Dong-quan/AutoCAD_Mechanical_Design/(list of files, cad)

Other CAD files:
12-D6.dwg
