Dong-quan/AutoCAD_Mechanical_Design/12-D6-A0H-BVL.pdf

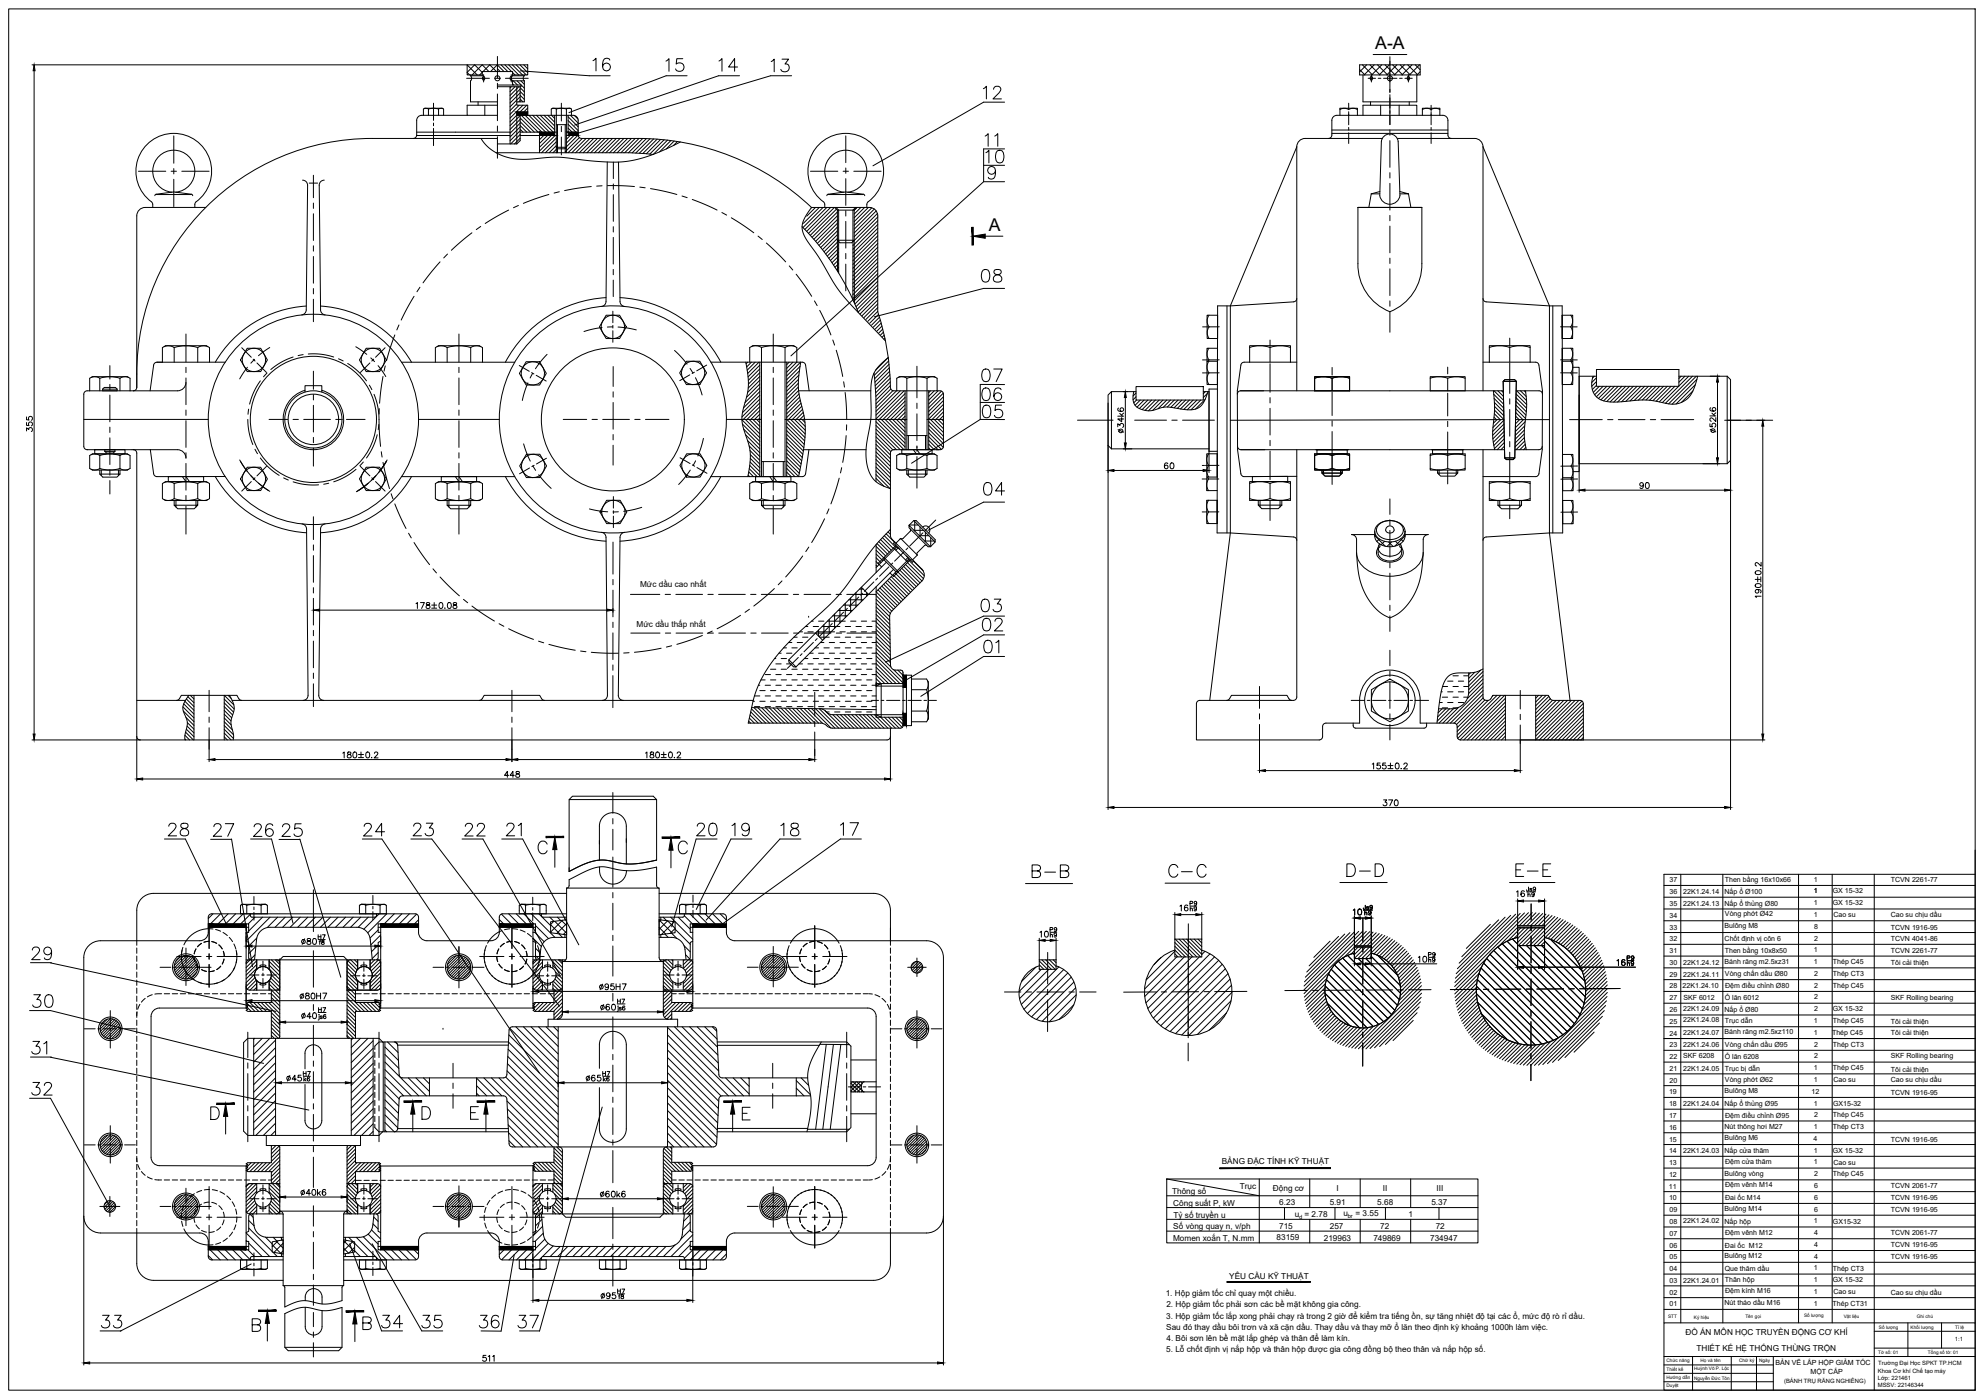
[picture p4: page 1]
Mức dầu cao nhất Mức dầu thấp nhất; Nút tháo dầu M16 Đệm kính M16 Thân hộp; Cao su Thép CT3 4 Đệm vênh M14; 6664 Đệm điều chỉnh Ø95 Bánh răng m2.5xz110 Trục dẫn Nắp ổ Ø80 Ổ lăn 6012 Đệm điều chỉnh Ø80 Vòng chắn dầu Ø80 Bánh răng m2.5xz31; Thép C45 1; Thép C45 222; Thép C45 2; Thép CT3 1; Thép C45 Then bằng 10x8x50 Vòng phớt Ø42 Nắp ổ thủng Ø80 Nắp ổ Ø100 Then bằng 16x10x66; Cao su 1; GX 15-32 GX 15-32 SKF 6012 Chức năng Thiết kế Hướng dẫn Duyệt; Họ và tên Huỳnh Võ P. Lộc Nguyễn Đức Tôn; Chữ ký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
