Dong-quan/AutoCAD_Mechanical_Design/12-D6-A3H-BANHRANG1.pdf

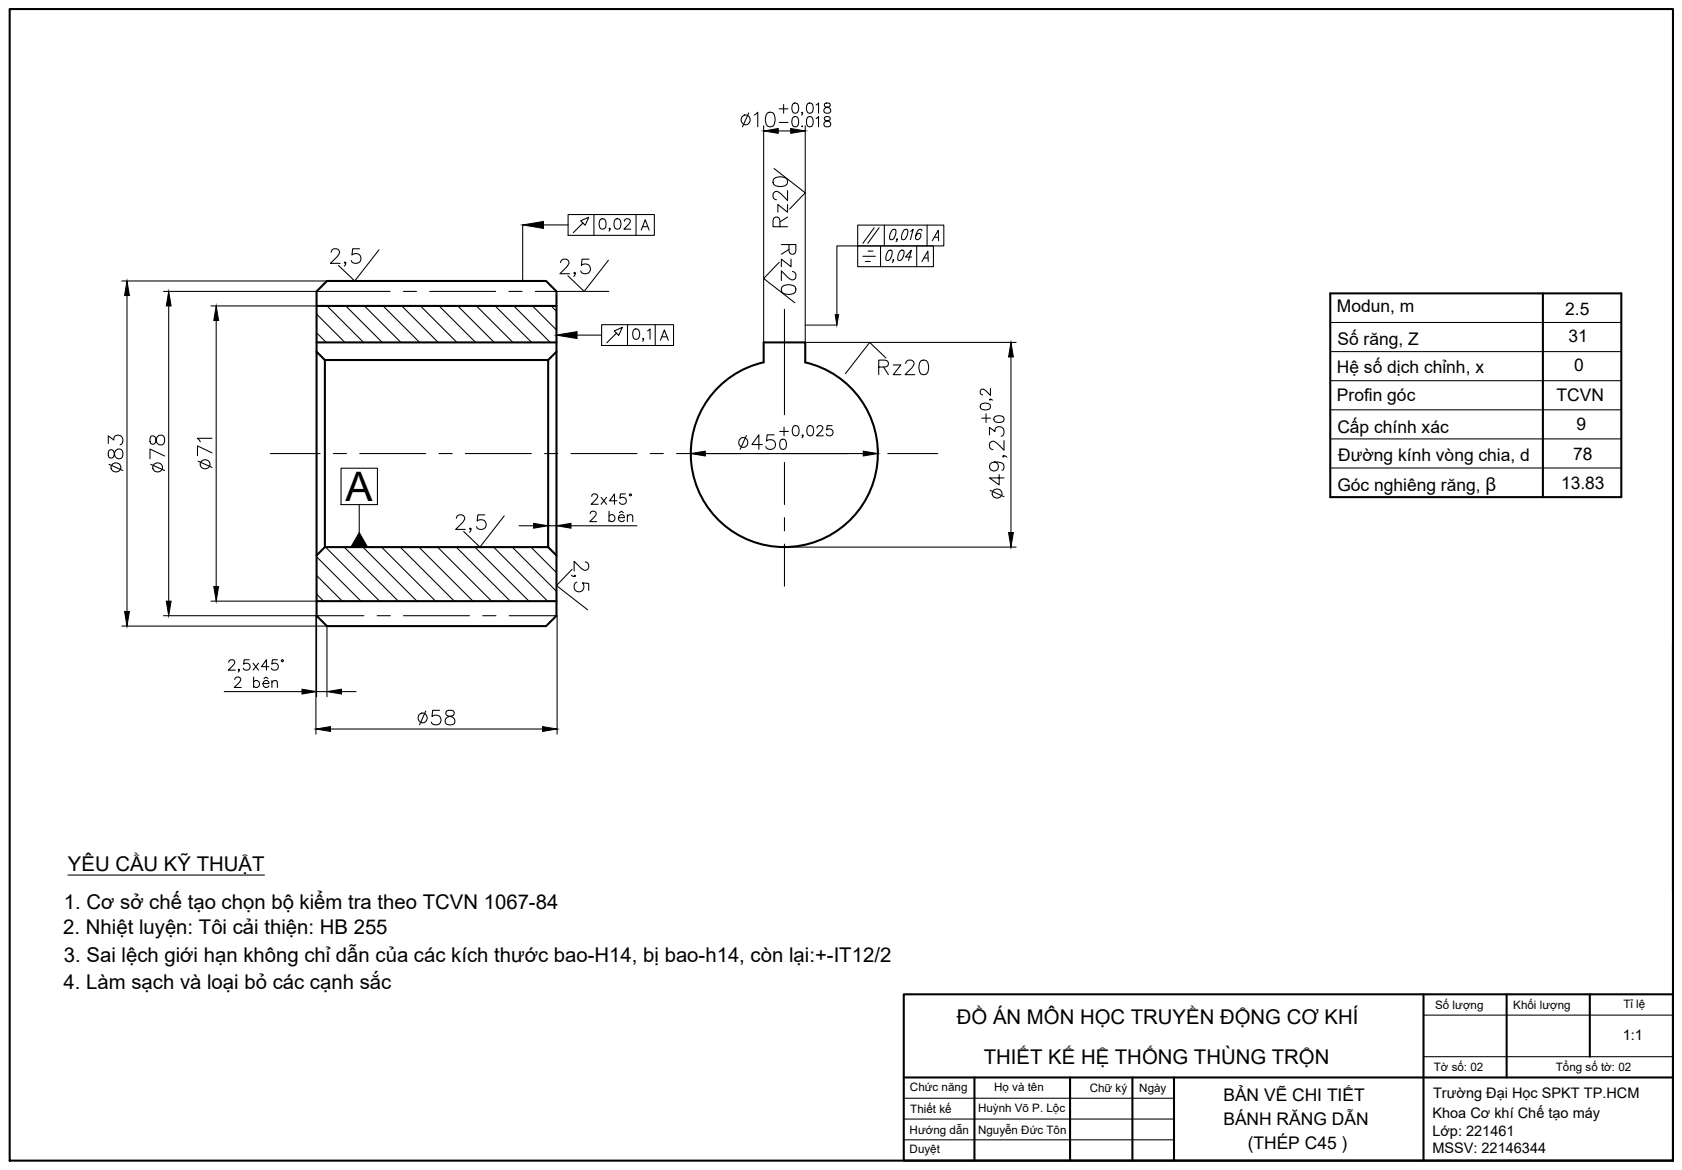
[picture p5: page 1]

Modun, m | 2.5
Số răng, Z | 31
Hệ số dịch chỉnh, x | 0

Profin góc | TCVN
Cấp chính xác | 9
Đường kính vòng chia, d | 78

Góc nghiêng răng, β

YÊU CẦU KỸ THUẬT

1. Cơ sở chế tạo chọn bộ kiểm tra theo TCVN 1067-84
2. Nhiệt luyện: Tôi cải thiện: HB 255
3. Sai lệch giới hạn không chỉ dẫn của các kích thước bao-H14, bị bao-h14, còn lại:+-IT12/2
4. Làm sạch và loại bỏ các cạnh sắc

ĐỒ ÁN MÔN HỌC TRUYỀN ĐỘNG CƠ KHÍ THIẾT KẾ HỆ THỐNG THÙNG TRỘN | Số lượng | Khối lượng | Tỉ lệ

Tờ số: 02 | Tổng số tờ: 02

Chức năng | Họ và tên | Chữ ký | Ngày | BẢN VẼ CHI TIẾT BÁNH RĂNG DẪN (THÉP C45 ) | Trường Đại Học SPKT TP.HCM Khoa Cơ khí Chế tạo máy Lớp: 221461 MSSV: 22146344
Thiết kế | Huỳnh Võ P. Lộc
Hướng dẫn | Nguyễn Đức Tôn
Duyệt
