Dong-quan/AutoCAD_Mechanical_Design/12-D6-A3H-TRUC1.pdf

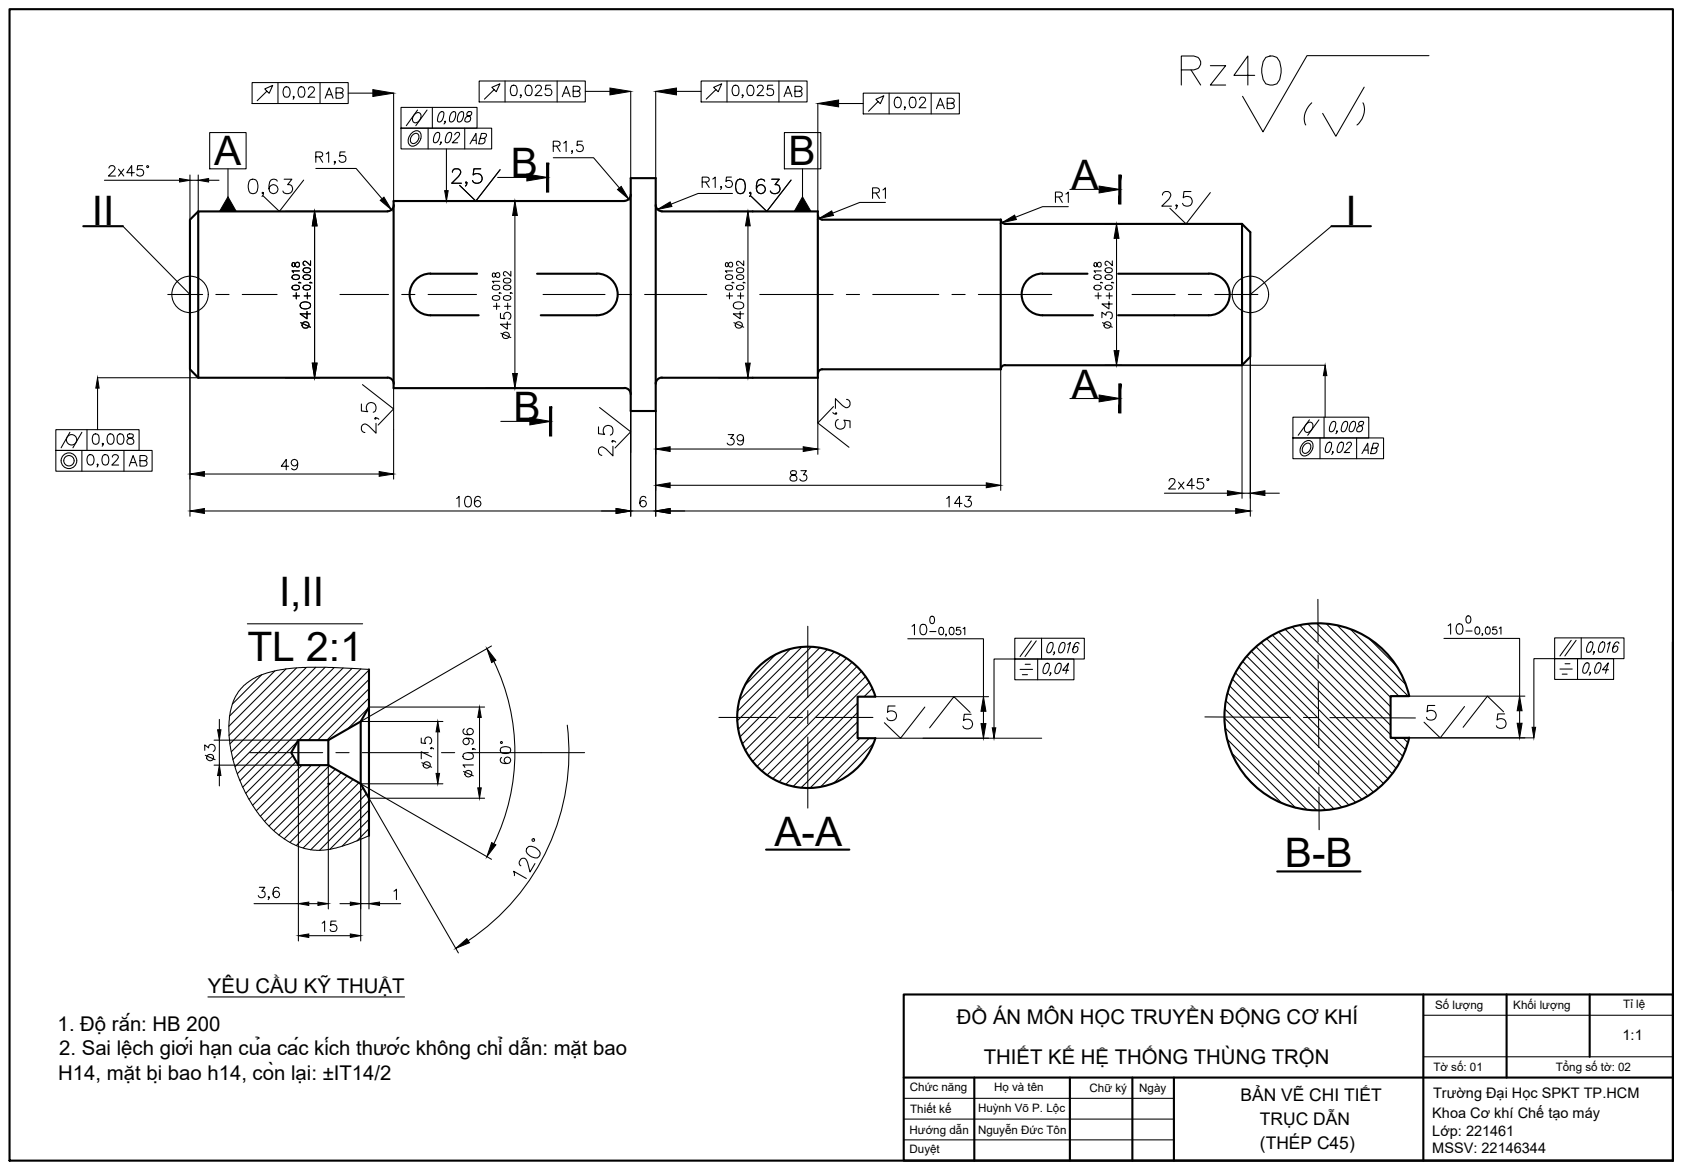
[picture p6: page 1]

YÊU CẦU KỸ THUẬT

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

2. Sai lệch giới hạn của các kích thước không chỉ dẫn: mặt bao
H14, mặt bị bao h14, còn lại: ±IT14/2

Tờ số: 01 | Tổng số tờ: 02

Chức năng | Họ và tên | Chữ ký | Ngày | BẢN VẼ CHI TIẾT TRỤC DẪN (THÉP C45) | Trường Đại Học SPKT TP.HCM Khoa Cơ khí Chế tạo máy Lớp: 221461 MSSV: 22146344
Thiết kế | Huỳnh Võ P. Lộc
Hướng dẫn | Nguyễn Đức Tôn

Duyệt
